hexeguitar/Expression-pedal-input/README.md

# Expression-pedal-input
Work in progress, HW design for an universal expression pedal input

Link to thread at Teensy Forum:
https://forum.pjrc.com/index.php?threads/universal-midi-expression-pedal.76457/

[Html BOM](https://hexeguitar.github.io/Expression-pedal-input/KiCad_project/bom/ExpIn_3_2025-02-24.html "Html BOM")
