hexeguitar/Expression-pedal-input/KiCad_project/ExpIn_3.pdf

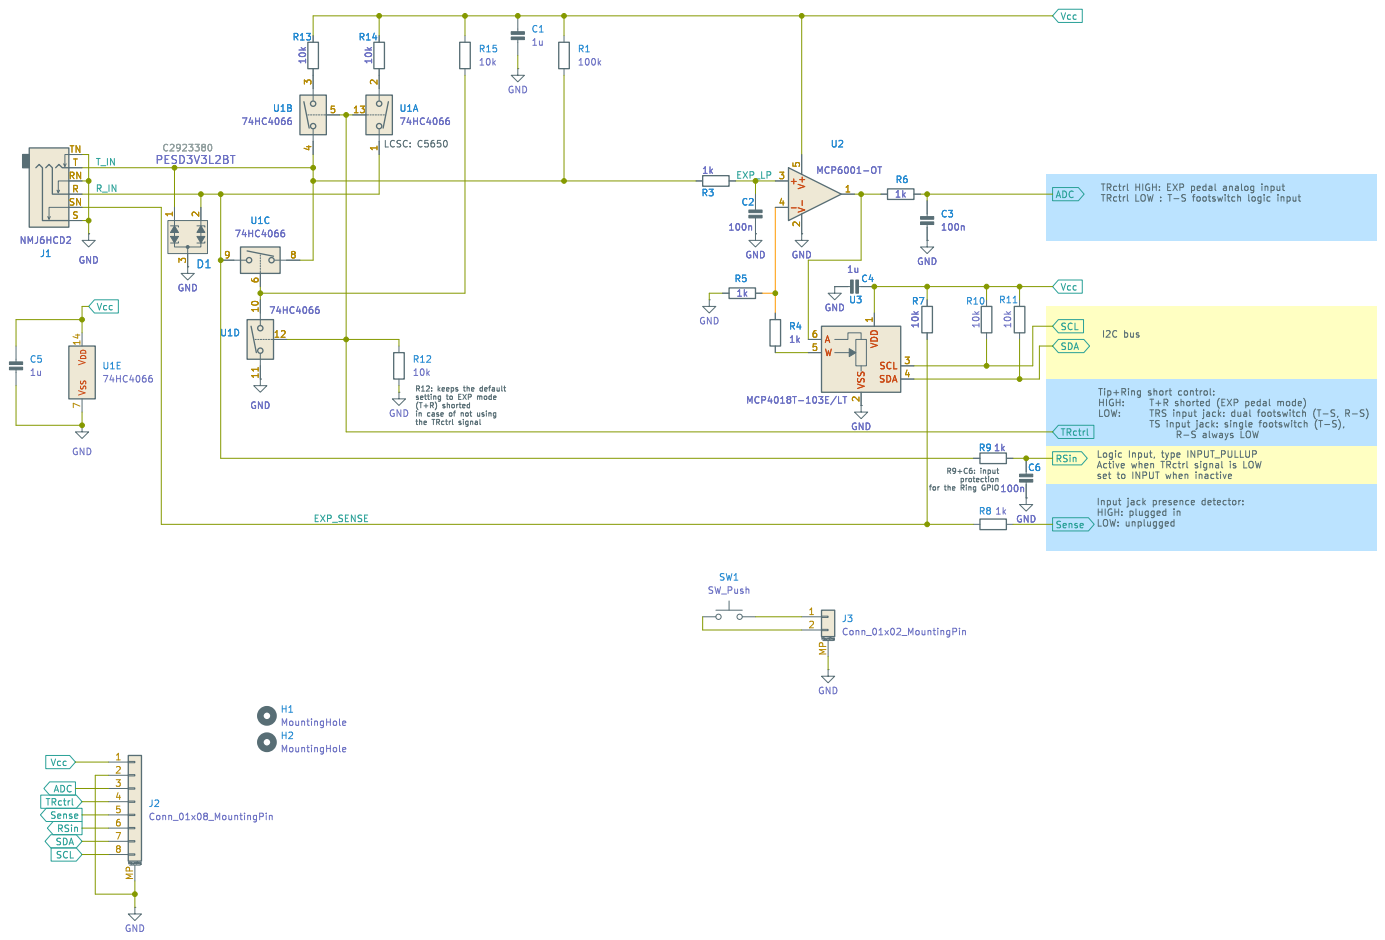
[picture p1: page 1]

(T+R) shorted
in case of not using

Logic Input, type INPUT_PULLUP
Active when TRctrl signal is LOW
set to INPUT when inactive

LOW: unplugged R9+C6: input protection

for the Ring GPIO

J3Conn_01x02_MountingPin SCL TRctrl Sense RSin SDA
