hexeguitar/Expression-pedal-input/KiCad_project/ExpIn_3.kicad_pcb

## KiCad design KiCad_project/ExpIn_3.kicad_pcb (2025-02-24)

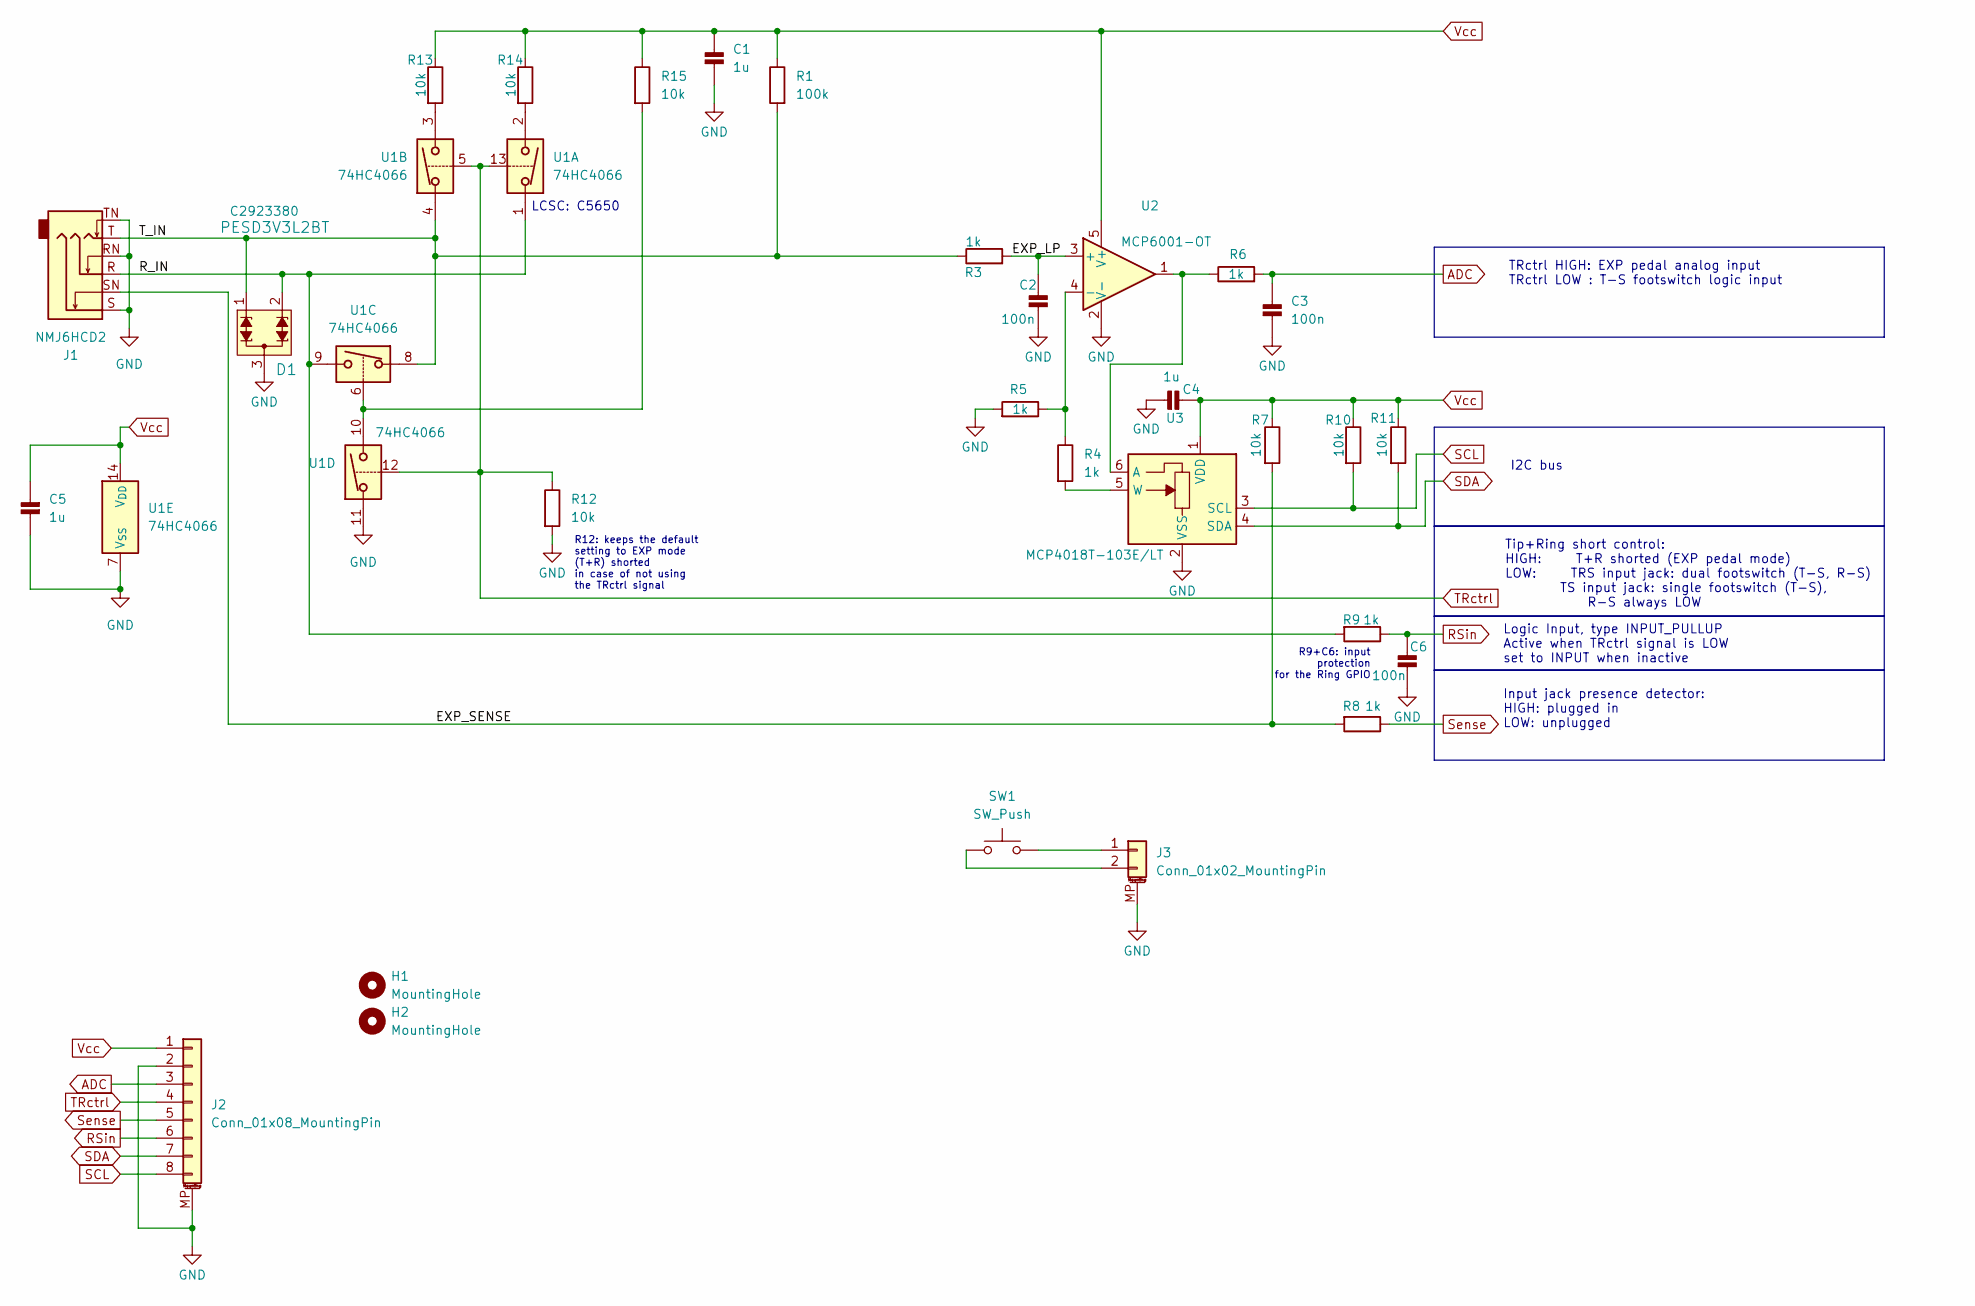
[picture p2: schematic ExpIn_3.kicad_sch]

Parts:
C1, C4, C5: 1u; Hx_C_0603_1608Metric
C2, C3, C6: 100n; Hx_C_0603_1608Metric
D1: PESD3V3L2BT; SOT-23; LCSC C2923380
H1, H2: MountingHole; MountingHole_3.2mm_M3
J1: NMJ6HCD2; Jack_6.35mm_Neutrik_NMJ6HCD2_Horizontal
J2: Conn_01x08_MountingPin; JST_SH_BM08B-SRSS-TB_1x08-1MP_P1.00mm_Vertical
J3: Conn_01x02_MountingPin; JST_PH_B2B-PH-SM4-TB_1x02-1MP_P2.00mm_Vertical
R1: 100k; Hx_R_0603_1608Metric
R3, R4, R5, R6, R8, R9: 1k; Hx_R_0603_1608Metric
R7, R10, R11, R12, R13, R14, R15: 10k; Hx_R_0603_1608Metric
SW1: SW_Push; SW_Tactile_SPST_Angled_PTS645Vx83-2LFS
U1: 74HC4066; TSSOP-14_4.4x5mm_P0.65mm
U2: MCP6001-OT; SOT-23-5
U3: MCP4018T-103E/LT; SOT-363_SC-70-6

Connections:
/EXP_LP: C2.1, R3.2, U2.3 (+)
/EXP_SENSE: J1.SN, R7.2, R8.2
/R_IN: D1.2, J1.R, R9.2, U1.1, U1.9
/T_IN: D1.1, J1.T, R1.2, R3.1, U1.4, U1.8
ADC: C3.1, J2.3, R6.2
GND: C1.2, C2.2, C3.2, C4.1, C5.1, C6.2, D1.3, J1.RN, J1.S, J1.TN, J2.2, J2.MP (MountPin), J3.MP (MountPin), R5.2, R12.2, U1.7 (V_{SS}), U1.11, U2.2 (V-), U3.2 (VSS)
unnamed: J3.1, SW1.2
unnamed: J3.2, SW1.1
unnamed: R13.2, U1.3
unnamed: R14.2, U1.2
unnamed: R15.2, U1.6, U1.10
unnamed: R4.1, R5.1, U2.4 (-)
unnamed: R6.1, U2.1, U3.6 (A)
unnamed: R4.2, U3.5 (W)
RSin: C6.1, J2.6, R9.1
SCL: J2.8, R10.2, U3.3 (SCL)
SDA: J2.7, R11.2, U3.4 (SDA)
Sense: J2.5, R8.1
TRctrl: J2.4, R12.1, U1.5, U1.12, U1.13
Vcc: C1.1, C4.2, C5.2, J2.1, R1.1, R7.1, R10.1, R11.1, R13.1, R14.1, R15.1, U1.14 (V_{DD}), U2.5 (V+), U3.1 (VDD)

Notes on the sheet:
LCSC: C5650
Input jack presence detector: HIGH: plugged in LOW: unplugged
I2C bus
R9+C6: input protection for the Ring GPIO
Logic Input, type INPUT_PULLUP Active when TRctrl signal is LOW set to INPUT when inactive
Tip+Ring short control: HIGH: T+R shorted (EXP pedal mode) LOW: TRS input jack: dual footswitch (T-S, R-S) TS input jack: single footswitch (T-S), R-S always LOW
R12: keeps the default setting to EXP mode (T+R) shorted in case of not using the TRctrl signal
TRctrl HIGH: EXP pedal analog input TRctrl LOW : T-S footswitch logic input

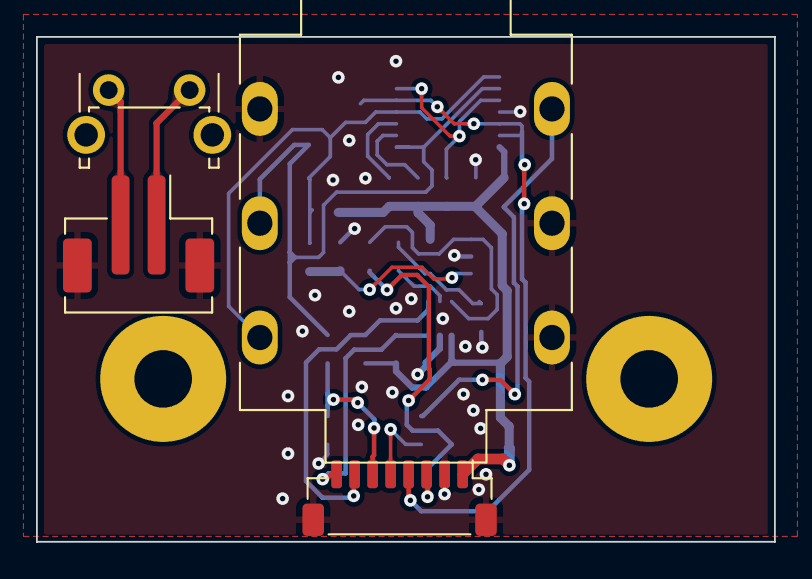
[picture p3: board ExpIn_3.kicad_pcb from above]

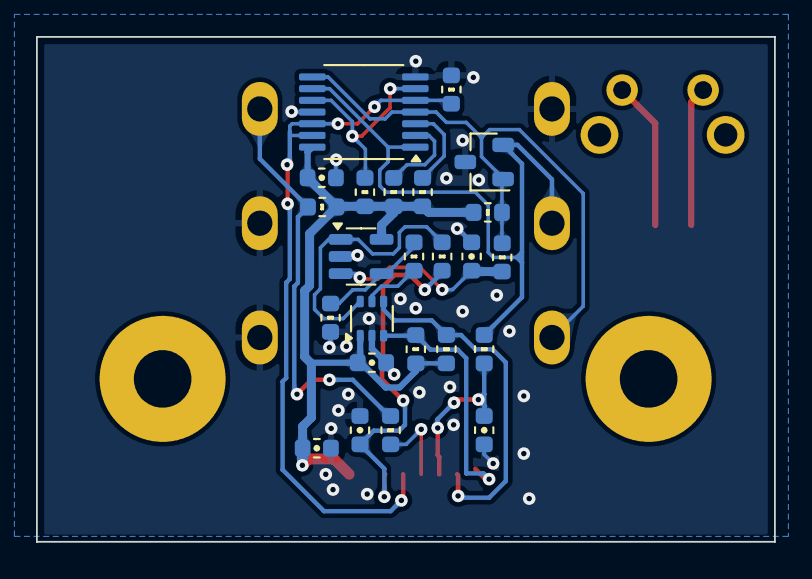
[picture p4: board ExpIn_3.kicad_pcb from below]

Board: 2 copper layers, 41.0 x 28.1 mm, 30 parts (24 on the bottom side), 20 nets.
