hexeguitar/Expression-pedal-input/(commit log)

2025-02-20 initial commit - V3
    [ExpIn_3.kicad_pcb, ExpIn_3.kicad_sch]
2025-02-24 SMT connectors, gain control
    [ExpIn_3.kicad_pcb, ExpIn_3.kicad_sch]
2025-02-24 board size update, dec. caps 1u, bom
    [ExpIn_3.kicad_pcb, ExpIn_3.kicad_sch]
2025-02-24 schematic pdf update
2025-02-24 readme update bom link
